xeonqq/SpeedyBirdie/pics/IMG_1552.JPG

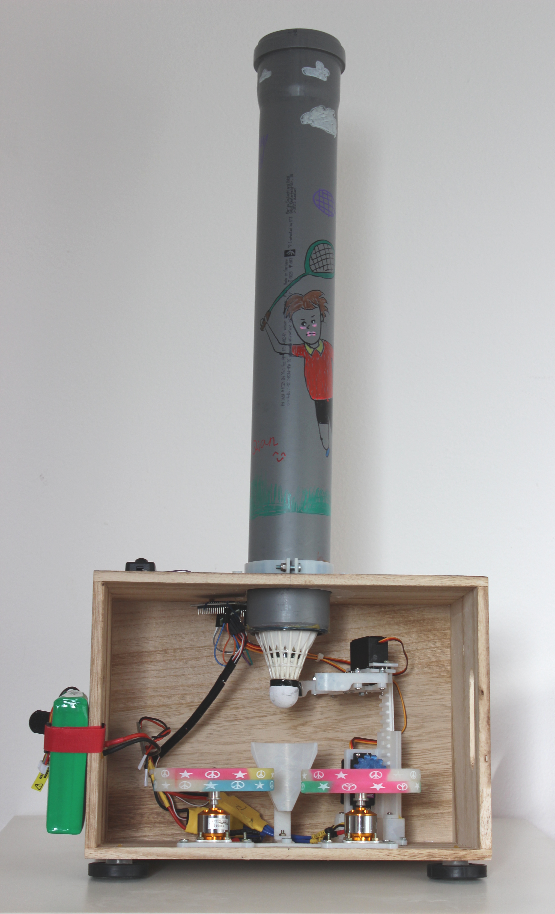
pics/IMG_1552.JPG
