xeonqq/SpeedyBirdie/(threads)

Thread 7 (2023-08-01):

Cannot find build instructions

hurrricane478, 2023-08-01:
Hi there,

Sorry about posting this here, but I haven't seen you active elsewhere on YouTube or Thingiverse. Would you mind posting some instructions on the build and the wiring for this?

Thank you so much, all the best.

xeonqq, 2023-08-02:
Hi,
Sorry, for now there is no detailed assembly instructions. I hope I can find time to do it someday. I leave this issue open as a reminder.

hurrricane478, 2023-08-02:
Okay, thanks for the quick reply. Would you mind posting a few extra pictures of the electronics when you have the time?

xeonqq, 2023-08-04:
Here you go:
https://github.com/xeonqq/SpeedyBirdie/tree/master#sponsor-content

hurrricane478, 2023-08-04:
Thank you!

vmartrix, 2023-08-12:
Sorry to jump in out of nowhere
I finished my speedy birdie assembly and I am now trying to adjust a bug on one of my ESC that keeps the motor spinning even without any instruction
@hurrricane478 I can help you with pictures of any part of it, if you want. I spent 2 days of my weekend trying to reverse engineering based on the pictures, 3d pieces and video
It's working, but I wasn't able to fully test on the badminton court

@xeonqq: your work is amazing! Thank you for all the code, 3d parts and everything. It's my first arduino project and I felt so happy when it worked. I am not a code, but I'm trying to add some additional functions, like pre-made shots (like Baddy), but it's a long term plan for me.
Count with me if I can help somehow

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

hurrricane478, 2023-08-12:
Hi @vmartrix! Good build you have there, and thanks for the offer for pictures. I was also planning to add some features, and I was mainly interested in the connection board used to distribute 5v from the ESCs to see if that would work with the extra components I was planning to add or if I needed another 5v source.

As for your ESC, I would see if you can easily switch them on the Arduino pins like if you had one ESC on pins abc and another ESC on xyz them switch the one of abc to xyz and vice versa (I don't use pin numbers here as this may cause confusion).

If the problem persists on the same ESC I would firstly check if that one if 100% wired correctly to the motor and if it is then it is likely the ESC that's gone. This is how it sometimes with Aliexpress components. Maybe disconnect the PWM pin altogether and see if it spins only with the voltage pins.

If it persists on the other ESC then the issue is either that it's wired to the Arduino correctly (check if the PWM cable of the motor is on a PWM pin of the Arduino) and if it is then it's likely a software or Arduino bug. If that is the case then I haven't properly studied the code so I can't help you on that yet. The Arduino forums are also a fantastic place. Worst case it is probably not drawing that much current if you keep it as is.

vmartrix, 2023-08-12:
@hurrricane478 unfortunately that's one thing that I cannot help, as I built a workaround for that
I am using a [NodeMCU](https://www.aliexpress.com/item/1005005470719229.html). It doesn't have a 5V port, so I decided to go to a different route. The servos are connected on the board's 3V and GND and on D5 and D6.
The ESCs are connected on the D0, D1 and one of them also a GND. That last GND was the only way I got it running, without it, they beep the "I don't have a PWM signal, pls help".
The 5Vs from the ESCs are ignored, so I have to power my NodeMCU with a normal powerbank.
I used a [Y splitter](https://www.amazon.de/dp/B09TXRT791) from the lipo battery to the ESCs

I tried to build with the [Wemos D1,](https://www.aliexpress.com/item/32465811688.html) but then I would have to keep a breadboard there to distribute the 5V from the ESC to the board and to both servos. As I have a spare powerbank, but not a spare breadboard, I decided to keep the NodeMCU there for now

Regarding my ESC problem on one motor, I just used a calibration code again, for a longer time, and it's not ghost-spinning anymore. Both are running fine and idling correctly.

hurrricane478, 2023-08-12:
Yeah, calibration was something I forgot about, good that you found that. The 2x 5V 2A from the ESCs is just enough for the amount of servos that I am driving as they won't be running at the same time for the most part. I will be using [these](https://www.aliexpress.com/item/1005003206231606.html?spm=a2g0n.shopcart.0.0.18f938daSleHVL&mp=1) for power distribution and I will keep the two ESC 5V channels separate, not in parallel.

I would be wary of powering the servos through the Arduino by the way, they can't supply much current, so I would check if your voltage step down chip is getting warm. Check the current ratings too, I only tend to use the built-in 5V and 3.3V for stuff like sensors.

vmartrix, 2023-08-12:
Where does this voltage step down is located? On the NodeMCU? I'm connecting them directly to the board's 3V and GND
How do I check what's the amp that the servos are demanding?

hurrricane478, 2023-08-12:
You can easily get specs by [looking up the part number of any component](https://www.google.com/search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 ) and getting current values. Using V=IR the current should be half that as it is for 6V, so a about 200mA to 450mA when moving normally (I would lean more toward the lower end of that range as they don't have much load) however if you set the grabber servo in a way that will mean it tries to squeeze the shuttle then you can easily hit the stall current for at least a brief moment of time, this would be 1.25A at 3V. I couldn't find good specs about the board's 3.3V pin but similar boards can supply only 80-250mA sustained and just maybe about 500mA peak.

If you want to measure this yourself then you need to use a multimeter connected in series between the servo and **one** of its voltage pins. It must be in series not parallel, you may cause a shortcircuit otherwise.

Also, these servos are designed to operate from 4.8V to 6V so I would take note of that too. This will reduce their operating speed. I will personally use the 5V from the ESCs as this gives me about as much power as I need as I will be adding 2 more steppers and a sensor to my design.

xeonqq, 2023-08-12:
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

Very nice build!

hurrricane478, 2023-08-13:
A bit random, how much does the machine weigh roughly? I know this can vary, I just need a rough figure. Thanks.

xeonqq, 2023-08-13:
I am again out of home for one week, so based on my muscle memory, maybe 1.5~2kg. @vmartrix maybe you can give a more accurate number.

vmartrix, 2023-08-13:
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

Thank you!
As a first project, it works better than I expected. You did an awesome work with the code

vmartrix, 2023-08-13:
> A bit random, how much does the machine weigh roughly? I know this can vary, I just need a rough figure. Thanks.

Yes, he is right.
Mine has some different components than his, but it's around 2kg
I used the same box he suggested and it's very light. I liked it.
The main variables are the 2200mah battery and the cardboard birdie tube
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

xeonqq, 2023-08-18:
@vmartrix it would be cool if you put your SpeedyBirdie picture also to https://www.thingiverse.com/thing:5827863/make, it serves as an unique central place, then I can link it on the GitHub front page for others to see.

vmartrix, 2023-08-18:
Sure, I can do that this weekend. I printed the tripod and I am planning to design and print a new lock for my cardboard tube. But for sure I can publish it there soon

hurrricane478, 2023-08-20:
Hi again everyone, would you guys mind doing a quick experiment for me? If you would tilt the feeder down 45° or close to that to simulate a smash and see if the shuttle comes out properly or if it misses the wheels. Thanks!

xeonqq, 2023-08-24:
I just tried, it doesn't work like that. When tilt it  45° downwards, the slide has no effect and the ball can not get good contact with the spin wheel

hurrricane478, 2023-08-24:
Okay, thanks for doing that. I might have an idea to fix that if you are ever interested in adding shot angle control.

vmartrix, 2023-08-24:
That sounds nice
I would like to see the solution for that. On my tests, I didn't go as far as 45 degrees. I guess only around 20 or 30 at most

hurrricane478, 2023-08-24:
There are two solutions, both have benefits and drawbacks, and both require serious modification to the machine.

Method 1 is to have a guard that keeps the shuttle in place and then push it in manually with a servo [like this](https://www.youtube.com/watch?v=3aRCU1ZyTPs). This requires an extra servo and cannot automatically control angle, and it places an obstruction in the shuttle's path, which may lower shuttle speed and distance. It is however quite simple.

Method 2 is to change the angle of the wheels that launch the shuttle rather than change the angle of the box, like the [Siboasi machine](https://youtu.be/-A9s2fgrcPo?si=2_rdC-GzyBdyCJuY&t=74) (apologies for the fact that the only demonstration of this that I could find being a 1 second moment at 1:13 in the video). This adds an extra servo too but this servo now adds automatic angle control too, but the mechanism will require more maths to get right. The meeting point of the shuttle and the wheels cannot move so the axis of rotation will have to be at the meeting point.

I am going with method 2 but I have not yet formally put my design into proper sketches/CAD or into the real world yet, but will update on progress. I am nearly at the building stage.

Closed 2023-08-04.

Thread 8 (2023-08-05):

Bearing dimensions

hurrricane478, 2023-08-05:
Hi again, thanks for posting those instructions, I have just got them. These will really help me get this together, and I hope my donation could pay for a nice coffee or something like that 🙂

I just wanted to quickly check one thing, one is for the bearing that is 10*4mm - does this mean 10mm outer diameter by 4mm inner diameter? Does the depth of the bearing matter?

Thanks for all your work on this, ever since [baddy](https://www.badmintoncentral.com/forums/index.php?threads/launcher-shuttlecock-baddy-cheap-open-source.172538/)  was abandoned you are the only one working on this.

xeonqq, 2023-08-06:
Hi, thanks for supporting the project. Regarding the bearing, I will check on Tuesday when I am back home, now on holiday.
But you can verify by printing
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

And

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

It is used to fit those two.

hurrricane478, 2023-08-06:
Fantastic, will take a look.

xeonqq, 2023-08-07:
Hi, I have updated the spec of the bearing as well as a replacement solution in the manual.pdf (Tips of Building Chapter). Check out if you can download the updated one?

hurrricane478, 2023-08-07:
No unfortunately I can't.

Closed 2023-08-07.

Thread 10 (2023-08-12):

After speed ~140 the silicone bands "expand". Do I use glue?

vmartrix, 2023-08-12:
Hello!
I've tried to use 2 different kinds of silicone band on the throwing wheel, but after around speed 140 set on the main page the silicone bands expand and start to damage the birdie slide platform and it doesn't throw the birdie properly anymore.
I don't remember with the thinner bands the problem was around the same speedy, but even with the [wider ones](https://www.aliexpress.com/item/1005005865378435.html) the problem keeps happenning.
Did you glue yours to the wheel?
Or is my speed way to high and/or my motors are uncalibrated?

xeonqq, 2023-08-12:
Yes, I face the same problem. I use epoxy to glue the rubber bands. But after extensive usage in high speed, even with glue it can still fall out. I have a slightly improved version of the spinning wheel in [ver2](https://github.com/xeonqq/SpeedyBirdie#sponsor-content). But it is still experimental since I didn't test it enough.
I am open with better ideas to fix the rubber bands.🙂

hurrricane478, 2023-08-13:
How about 3D printer timing belts? They often have metal wire in them to prevent stretching.

vmartrix, 2023-08-16:
> Yes, I face the same problem. I use epoxy to glue the rubber bands. But after extensive usage in high speed, even with glue it can still fall out. I have a slightly improved version of the spinning wheel in [ver2](https://github.com/xeonqq/SpeedyBirdie#sponsor-content). But it is still experimental since I didn't test it enough. I am open with better ideas to fix the rubber bands.🙂

The only other option that I saw was to use a small rubber tire, for a RC truck or something like that. But it was on a different wheel design

Do you thing that hot glue would fly away due to centrifugal force as well?

vmartrix, 2023-08-16:
Oh, I didn't know they had this name. Then we'd have to design a grooved wheel, right?

hurrricane478, 2023-08-16:
Possibly, although maybe the toothed part could face outwards, it may grip okay. I just thought of them because they have a metal core to stop them expanding over time.

hurrricane478, 2023-08-16:
Yeah, maybe it would be most beneficial to have the teeth inward to gain stability, and at that point new wheels will be needed.

xeonqq, 2023-08-17:
Close, since the question is answered.
Feel free to keep brainstorming in this thread.

Closed 2023-08-17.

Thread 11 (2023-08-13):

Can not flash bin file

KinInEngland, 2023-08-13:
I flashed firmware successfully with flash download tool 3.9.2.But the problem is i can not find the wifi signal named "SpeedyBirdie".I do a little research that there is two kind of esp8266.nodemcu v1.0 from Amica and nodemcu v3 from other group.I can not figure out the problem.Best wish.
I can not upload the picture or video so i describe to you . The sofeware displayed "finish". The board blue led flash glimmered rapidly.

KinInEngland, 2023-08-13:
https://github.com/xeonqq/SpeedyBirdie/assets/142132789/5bb86d88-721e-4cdc-bc28-8dd7c99600e9

KinInEngland, 2023-08-13:
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

xeonqq, 2023-08-13:
Hi, could you try spi mode DIO, as documented [here](https://payhip.com/b/kO4ir) in the picture.

KinInEngland, 2023-08-13:
the same problem.i don't know why.

KinInEngland, 2023-08-13:
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

xeonqq, 2023-08-13:
Then I also don't know, maybe try method 2?

xeonqq, 2023-08-13:
Btw, don't forget to power cycle the board after flashing.

KinInEngland, 2023-08-14:
https://github.com/xeonqq/SpeedyBirdie/assets/142132789/988efa23-cf42-42df-ae00-b8527bf8303b

finally，the problem is the version of the board .btw the software seem to have little problem.

KinInEngland, 2023-08-14:
i cannot change the number like the shooting power.

xeonqq, 2023-08-14:
Could you describe what is the version that's working and what is not working? So that future users could benefit.

Regarding the number problem, I will have a look next week, now out of home and I don't have the hardware.

helloworldleung, 2023-08-14:
ok，i will do it

helloworldleung, 2023-08-14:
what's more,could you tell me more about the size of the box and more detail like the screw pitch. I want to print a box.

xeonqq, 2023-08-14:
See thingiverse for box dimensions. Pitch I don't know. I use the screws from [ikea](https://www.ikea.com/us/en/p/fixa-200-piece-wood-screw-set-70224228/)

KinInEngland, 2023-08-15:
https://github.com/xeonqq/SpeedyBirdie/assets/142132789/739caa66-c011-4efe-ae06-587764c73fd9

https://github.com/xeonqq/SpeedyBirdie/assets/142132789/e6b492b4-754c-4665-a1f0-e6c7981fdbe5

KinInEngland, 2023-08-15:
hello，i want to make sure that when i press the start feeding the icon will chang?

helloworldleung, 2023-08-17:
https://github.com/xeonqq/SpeedyBirdie/assets/110042413/c867b87d-297d-4048-9c20-2f75374102b7

https://github.com/xeonqq/SpeedyBirdie/assets/110042413/d7bbc87b-3394-4e93-993a-809dfdb49a7e

helloworldleung, 2023-08-17:
hello，i have a question that the motor will start when connect to the power?i gave the signal to the board by the phone but it seem to me than it didn't work.(i connect the pin d2 to pin 3v3 on the board)

xeonqq, 2023-08-17:
Check your connections and you can use 192.168.0.1/dev.html to debug the motors/servos easier.

xeonqq, 2023-08-17:
Close, it seems there is no problem with the pre-compiled bin firmware.

Debugging user specific hardware problem is out of scope for the maintainer.

Closed 2023-08-17.

Thread 12 (2023-08-24):

Serving time lower than 3 seconds doesn't save

vmartrix, 2023-08-24:
Hello!

I've tried to set for a 2.0 serving time on the main screen, but even after clicking on Save Config, if I refresh the page, it comes back to 3 seconds.
And if I try Save Config and then Run the process, it doesn't work either.

Do you also face this issue or is it with my build?

I've used the original way of flashing the drive, with the whole docker process

xeonqq, 2023-08-24:
it is intended behavior, due to physical limitation of the servos. Namely, the grabber and the lifter can not move simultaneously, and their motion takes time.

see: https://github.com/xeonqq/SpeedyBirdie/blob/master/app/application.cpp#L227

you can push the limit of the servos by making them moving faster, then the interval lower bound will go lower.
have to change L11-L13: https://github.com/xeonqq/SpeedyBirdie/blob/master/app/application.cpp#L11
And recompile, there are hard-coded for now.

vmartrix, 2023-08-24:
Ah, okay. Good to know.
Recompile means to run _make flash_ and then _make flashapp_?

And considering that you mentioned recompiling, if I were to edit the main.html to include a button to dev.html for example, do I have to just make this edit on the .html files and then do the same process? Or is there any other dependency?

xeonqq, 2023-08-24:
```make flash``` will do a fresh install of everything onto the board (code and website)
```make flashapp``` will only upload code to the board (website will not be updated)

no other deps, just modify the html and ```make flash```, you can consider submit a PR afterwards, I think it is a good feature to have a dev.html redirect button

KinInEngland, 2023-08-26:
https://github.com/xeonqq/SpeedyBirdie/assets/142132789/09fd9a4b-86c5-4a25-8ce7-e2f9cdd9484c

hello，it seem to me that the mechanism is ok but when i started the servo have no a action do you kow why ?

KinInEngland, 2023-08-26:
hello，it seem to me that the mechanism is ok but when i started the servo have no action do you kow why ?

xeonqq, 2023-08-26:
@KinInEngland I have already answered your question here https://github.com/xeonqq/SpeedyBirdie/issues/11#issuecomment-1682818255, you need to configure the setting in dev.html.

Your comments is not related to the current issue at all.

xeonqq, 2023-08-26:
question has been answered

xeonqq, 2023-09-04:
> Ah, okay. Good to know. Recompile means to run _make flash_ and then _make flashapp_?
>
> And considering that you mentioned recompiling, if I were to edit the main.html to include a button to dev.html for example, do I have to just make this edit on the .html files and then do the same process? Or is there any other dependency?

I added this button to navigate to dev page in master now.

Closed 2023-08-26.

Thread 13 (2023-08-29):

hello，why the servo did not have motion？

KinInEngland, 2023-08-29:
hello，here is the description. i connected the battery and then the servo(both the upper one and the lower one) initialized motion but when i press the "start feeding",the motor start rotate and the servo take no action. First time ,i connected the D2 pin and 3V3 pin together because i think that i didn't give a beginning signal.This way is failed.Second , i entered the dev/html page , i try to change the value of servo and then the lower one take some action ,but the upper one still motionless.Do you know why?thx~

KinInEngland, 2023-08-29:
btw,what is the function of the start buttom?Am i connected correctly?

xeonqq, 2023-08-29:
The instant change slide bar can control only one servo, you can just swap the pin of the servos, then you can test the other servo with the same slide bar. (I am just too lazy to implement it in software, since it can be easily done like I said before, or just set a different initial value in dev.html, it can also reflect the change.)

As I said [here](https://github.com/xeonqq/SpeedyBirdie/issues/11#issuecomment-1682823264), so closing this.

Seems you are eager to build Speedybirdie, I created a special [consulting service](https://payhip.com/b/PjRZd) in case you really need it.

Closed 2023-08-29.

Thread 14 (2023-09-03):

hello，i want to know more

KinInEngland, 2023-09-03:
hello，could you tell me what kind of programming sofeware you used in this project?

xeonqq, 2023-09-03:
I don't get the question. The project is open source.

xeonqq, 2023-09-03:
Btw, please do not mis-use GitHub issue for things like this in the future. Issues are to track feature development or bugs.
Please refer to https://docs.github.com/en/issues for more info.

Closed 2023-09-03.
