xeonqq/SpeedyBirdie/include/esp8266_pins.h

/*
  pins_arduino.h - Pin definition functions for Arduino
  Part of Arduino - http://www.arduino.cc/

  Copyright (c) 2007 David A. Mellis
  Modified for ESP8266 platform by Ivan Grokhotkov, 2014-2015.

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
  $Id: wiring.h 249 2007-02-03 16:52:51Z mellis $
*/

#ifndef Pins_Arduino_h
#define Pins_Arduino_h

#define PIN_WIRE_SDA (4)
#define PIN_WIRE_SCL (5)

static const uint8_t SDA = PIN_WIRE_SDA;
static const uint8_t SCL = PIN_WIRE_SCL;

#ifndef LED_BUILTIN
#define LED_BUILTIN 2
#endif
#define LED_BUILTIN_AUX 16

static const uint8_t D0 = 16;
static const uint8_t D1 = 5;
static const uint8_t D2 = 4;
static const uint8_t D3 = 0;
static const uint8_t D4 = 2;
static const uint8_t D5 = 14;
static const uint8_t D6 = 12;
static const uint8_t D7 = 13;
static const uint8_t D8 = 15;
static const uint8_t D9 = 3;
static const uint8_t D10 = 1;

#endif /* Pins_Arduino_h */
