xeonqq/SpeedyBirdie/(commit log)

2022-11-27 Fix loading of parameters
    [AppSettings.h, application.cpp, planned_servo.h]
2022-11-27 Add feeding_loop and fix motor init bug
    [application.cpp, motor_composite.h, planned_servo.h]
2022-12-26 Replace pushing servo with another release servo
    [application.cpp]
2023-01-23 Adapt timing for new servo setup
2023-01-26 Increase pwm range for lifter servo
2023-01-30 Add additional button support to start/stop
2023-02-05 Increase button noise delay
    [application.cpp]
2023-04-02 Add donate button
2023-04-16 Fix bug in physical start/stop button
    [application.cpp]
2023-08-07 Remove paypal button
