xeonqq/SpeedyBirdie/(notices)

Notices in the files:
include/esp8266_pins.h:
Public License along with this library; if not, write to the
Free Software Foundation, Inc., 59 Temple Place, Suite 330,
Boston, MA 02111-1307 USA
